Velixtonia/Perrito_Firu_Industrial/ROBOTDOGCIRCUIT.png

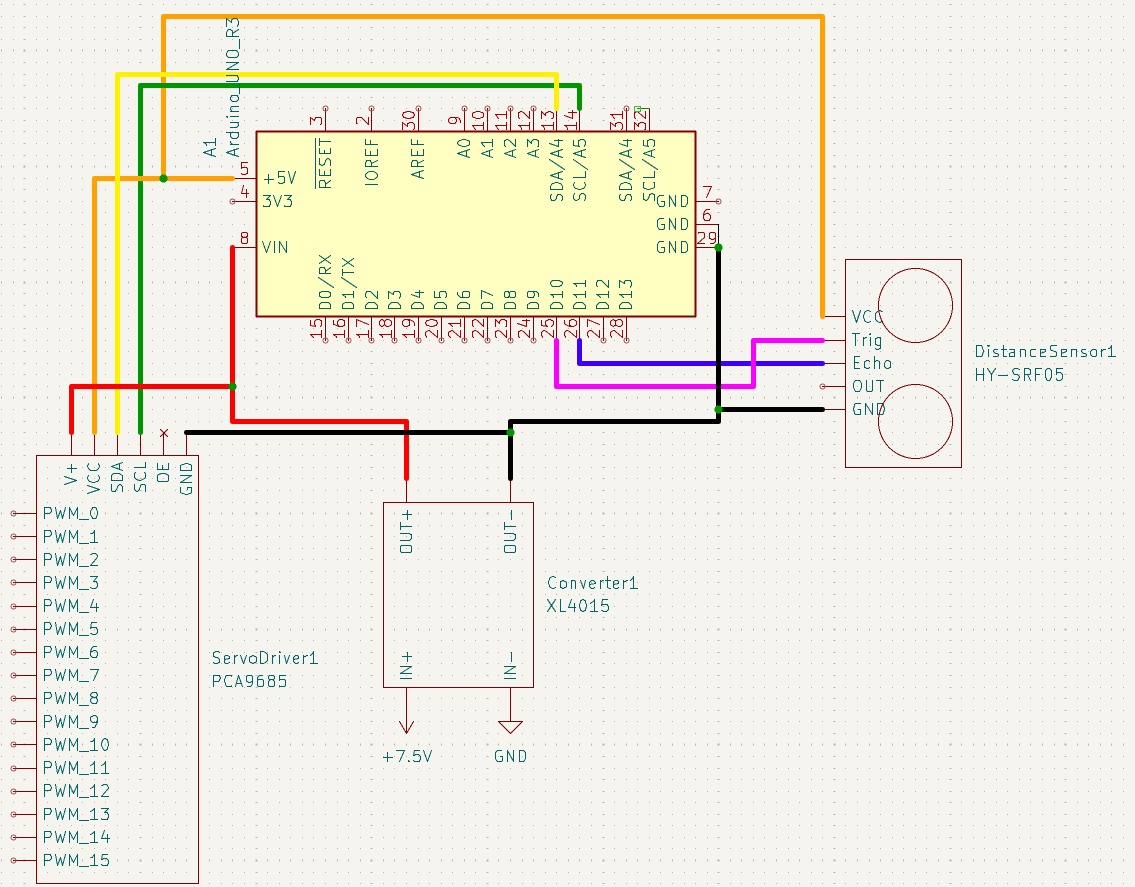
ROBOTDOGCIRCUIT.png
