Velixtonia/Perrito_Firu_Industrial/TibiaL (1).stl

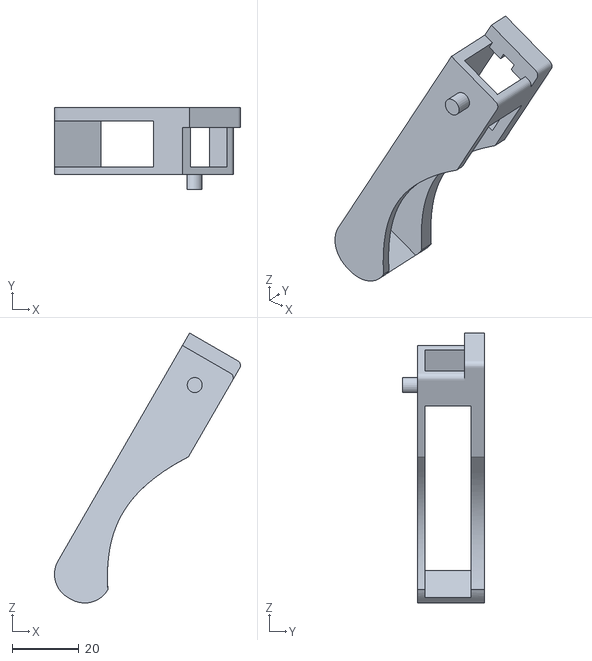
[picture p6: CAD file, 2026-11-07]
TibiaL (1).stl
55.6 x 24.4 x 80.7
