Velixtonia/Perrito_Firu_Industrial/FemurRight (1).stl

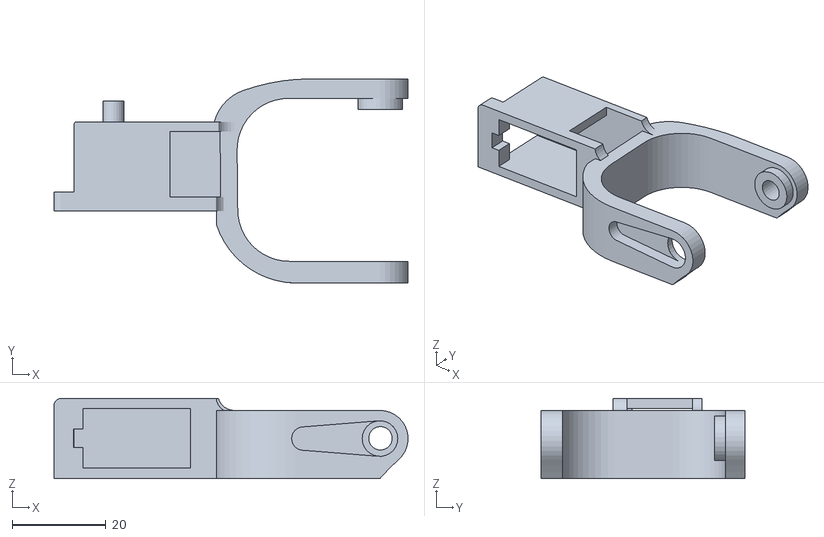
[picture p7: CAD file, 2026-11-07]
FemurRight (1).stl
75.5 x 43.6 x 17.1
