Velixtonia/Perrito_Firu_Industrial/UpperSpine (1).stl

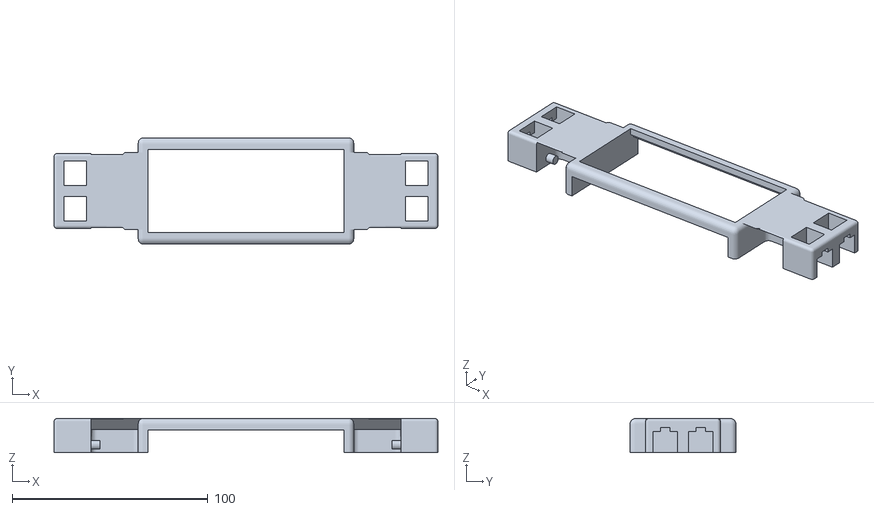
[picture p8: CAD file, 2026-11-07]
UpperSpine (1).stl
196.0 x 54.2 x 17.4
