Velixtonia/Perrito_Firu_Industrial/HipFrontRight-BackLeft (1).stl

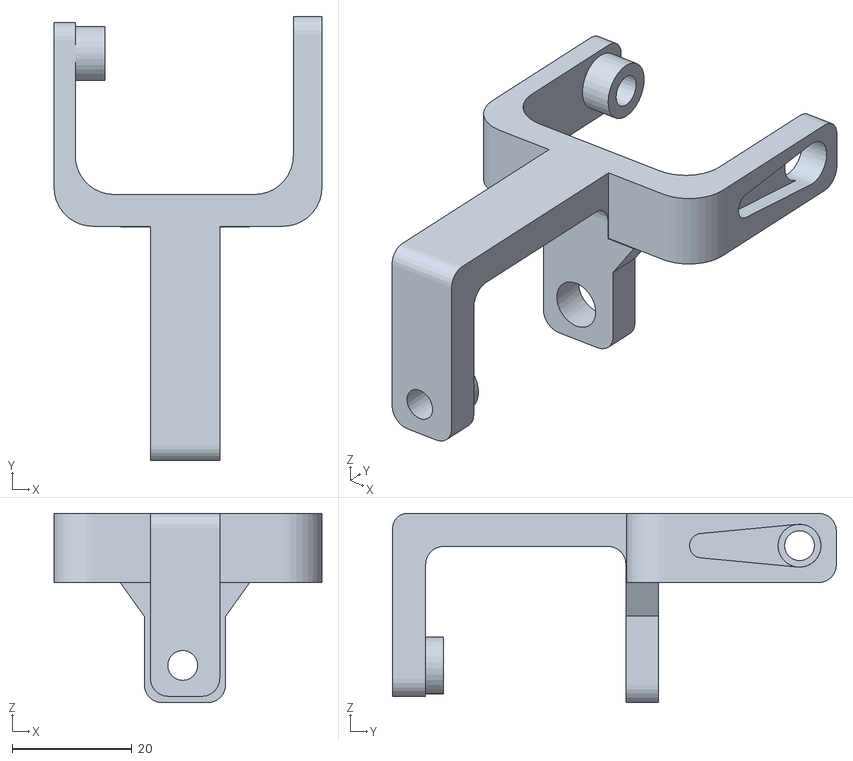
[picture p9: CAD file, 2026-11-07]
HipFrontRight-BackLeft (1).stl
44.8 x 74.2 x 31.7
