Velixtonia/Perrito_Firu_Industrial/LowerSpine (1).stl

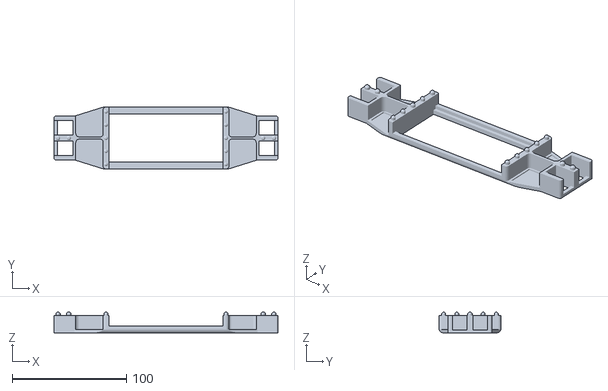
[picture p10: CAD file, 2026-11-07]
LowerSpine (1).stl
196.0 x 54.2 x 18.0
