Velixtonia/Perrito_Firu_Industrial/(list of files, cad)

Other CAD files:
TibiaR (1).stl
FemurLeft (1).stl
